codingABI/SenderReceiver/Receiver/data/gui01.bmp

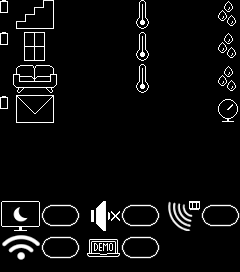
Receiver/data/gui01.bmp
