codingABI/SenderReceiver/Receiver/secrets.h

// File for data which should not be published to the public

// Device name
#define HOSTNAME "yourdata"

// OTA password
#define OTAPASSWORD "yourdata"

const char g_eepromenc[] = "yourdata"; // Key for encrypting sensible data in eeprom

// Blynk
#define BLYNK_TEMPLATE_ID           "yourdata"
#define BLYNK_TEMPLATE_NAME         "yourdata"
#define BLYNK_AUTH_TOKEN            "yourdata"

// Thingspeak
#define THINGSPEAKAPIKEY "yourdata"
