codingABI/SenderReceiver/(commit log)

2023-01-27 Update webserver.ino
    fix snprintf
    [webserver.ino]
2023-03-11 Add missing display string
    [signals.ino]
2023-05-18 Add Sensor6
2023-10-01 Update
    - Delete oldest sn*.csv file when LittleFS has to less free space
    -Update code for Blynk 1.3.0
    -Add support for Emil Lux 315606 power outlets
    - List used libraries
2023-10-02 Update device name and example defines
2023-10-10 ASK/Blynk improvements
    - Prevent delays while checking 433Mhz signals to avoid missed signals
    - Remove Blynk for SolarPoweredSender sensor because Blynk in free plan reduces datastreams per template from 10 to 5 at 16.10.2023 (Second reduction in 2023, not nice)
    [Receiver.ino, display.ino, signals.ino, webserver.ino]
2023-11-03 Improve low/full battery detection
    - Adjust low battery warning level and improve full charge detection
    - Use spare pin 27 to detect switched off battery
2023-11-03 Update for pin 27
2023-11-03 Change color for pin 27
2023-11-03 Add devices overview
2024-03-01 Fix label in schematic
2024-04-08 Increase expected battery runtime
2024-04-08 Update expected battery runtime
2024-10-02 Update for arduino-esp32 .0.5
2025-02-05 Updates idf, Store main display data in EEPROM
    Update arduino-esp32 from 3.0.5 to 3.1.1 (IDF v5.3.2),
    Fix missing buzzer tones
    Enable/Disable ESP-NOW by "define"
    Store line graph, last data set, mail alert and uptime to EEPROM to be restored after a reset
    Send uptime to Thingspeak
    [EEPROM.ino, Receiver.ino, display.ino, externalCode.ino, sensordata.h, signals.ino, webserver.ino]
